BenKohn2004/Mask_Lights_and_VMS/VSM Mask Lights Enclosure.jpg

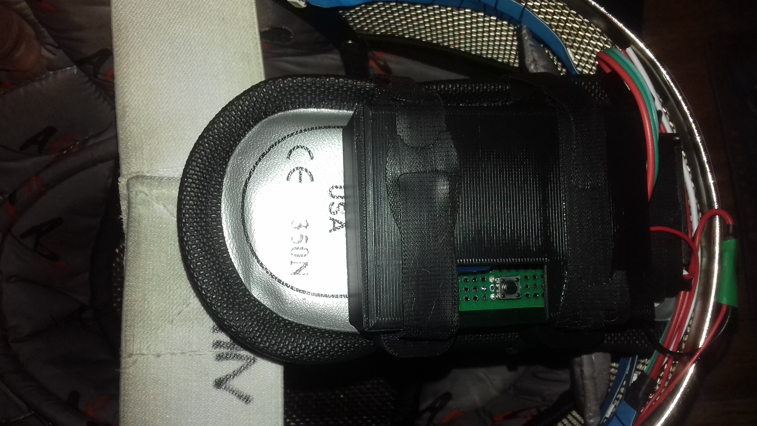
VSM Mask Lights Enclosure.jpg
