BenKohn2004/Mask_Lights_and_VMS/VSM Mask Lights Circuit.jpg

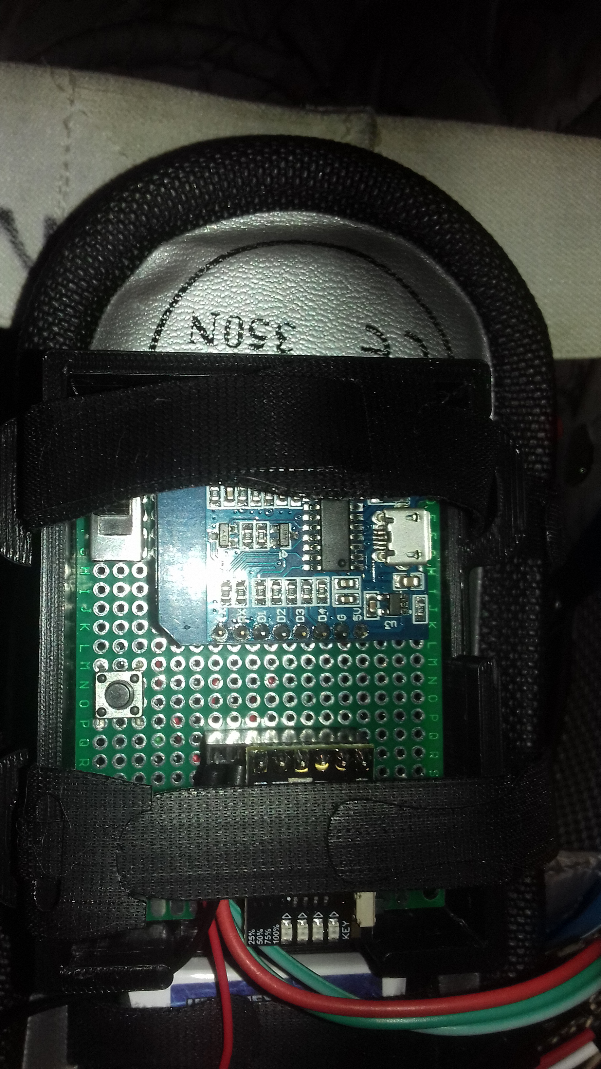
VSM Mask Lights Circuit.jpg
