BenKohn2004/Mask_Lights_and_VMS/Mask_Circuit_Enclosure.png

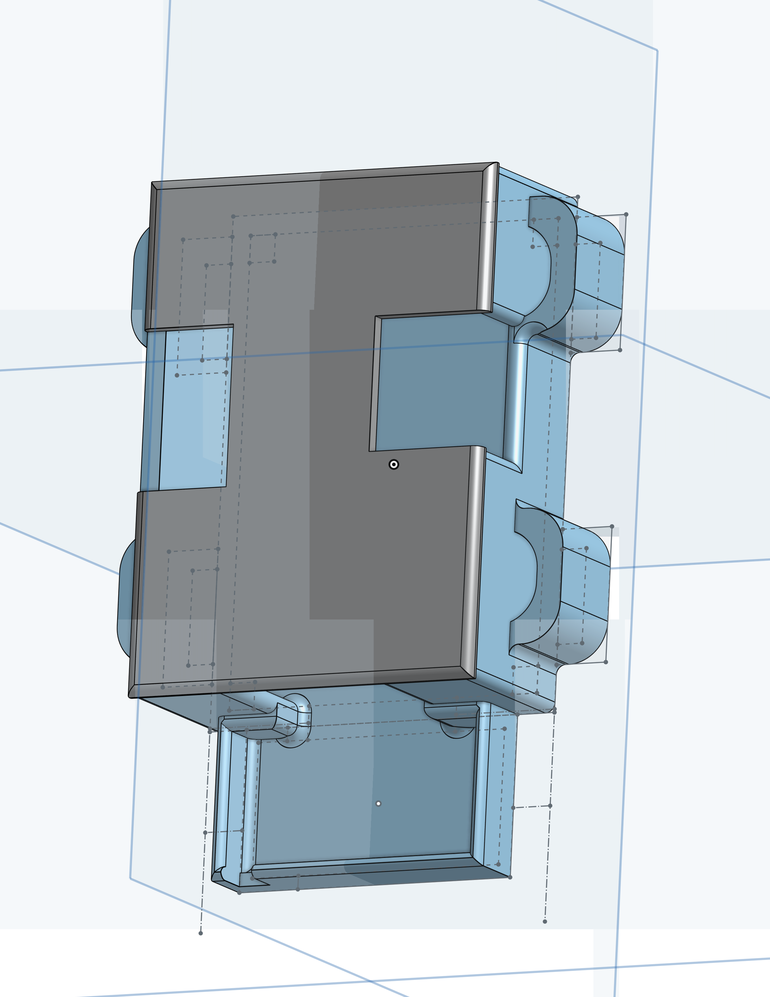
Mask_Circuit_Enclosure.png
