BenKohn2004/Mask_Lights_and_VMS/Schematic_Fencing Mask Lighting Wemos and VSM.png

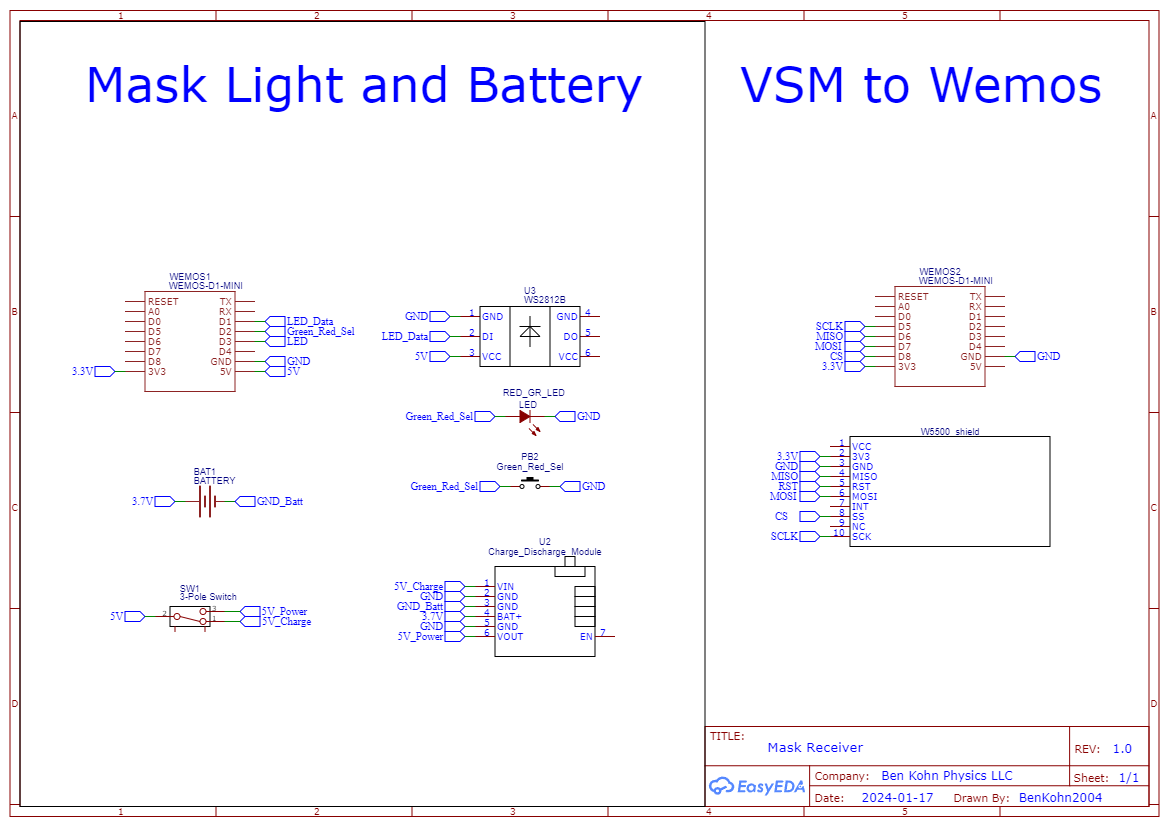
Schematic_Fencing Mask Lighting Wemos and VSM.png
